danielopaleye01/SmartHomeSystem/Smart Home System PROTOtype.md

Smart Home System PROTOtype

HC-SR501 Motion SENSOR

-Multiple sensors across the home that detect for motion, (excluding pets)

DHT11 sensor

-After base temperatures set, If under, turns on, if over, turns off/down. Activates when you enter the home

FAN & DC motor

-Turns on, turns off, on command
