danielopaleye01/SmartHomeSystem/Block diagram.pdf

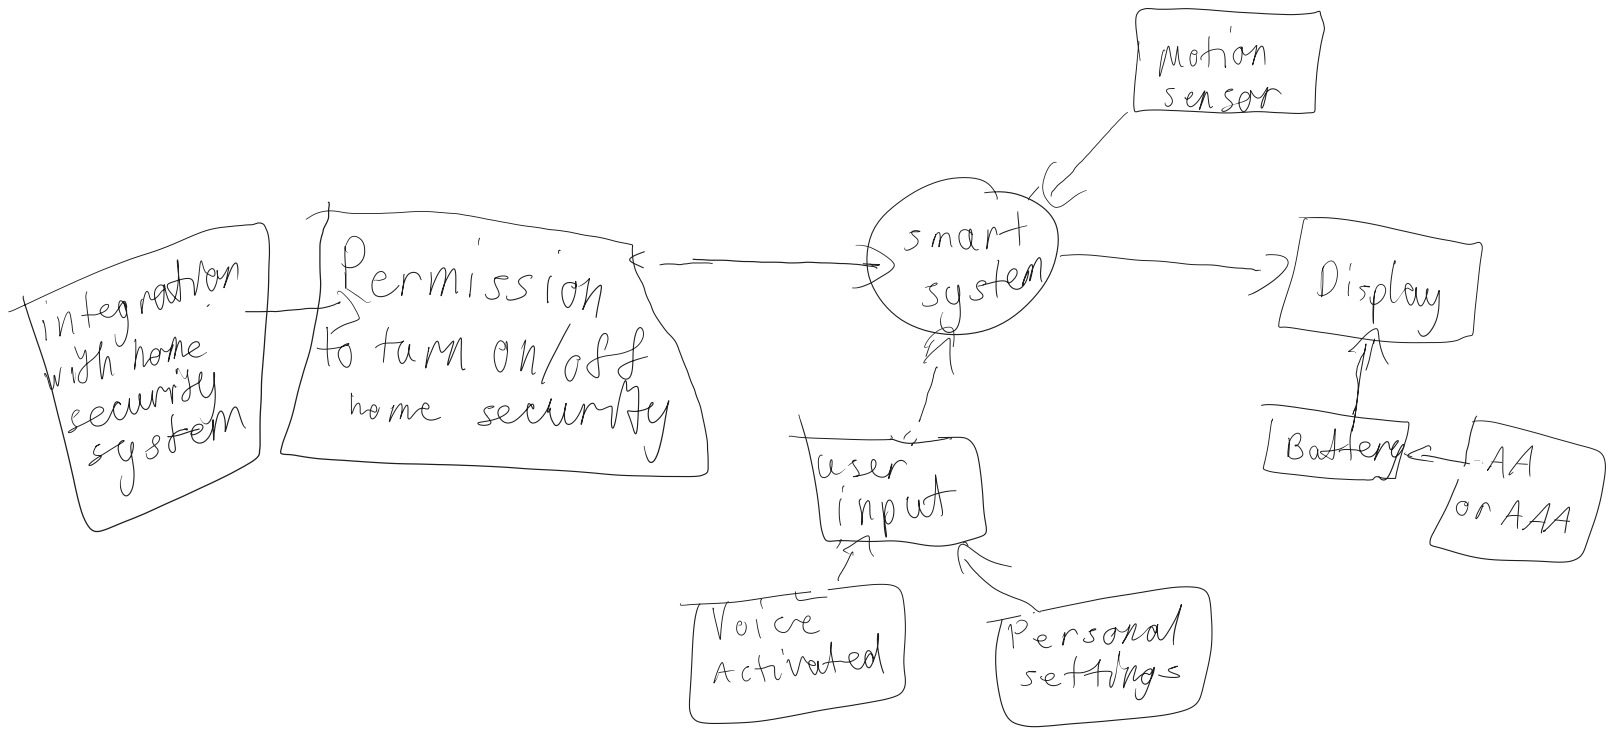
[picture p1: page 1]
