danielopaleye01/SmartHomeSystem/Final_Project430 2/Final_Project430 2/ProjectScematic_PCBv2.kicad_pcb

## KiCad design Final_Project430 2/Final_Project430 2/ProjectScematic_PCBv2.kicad_pcb (2025-05-15)

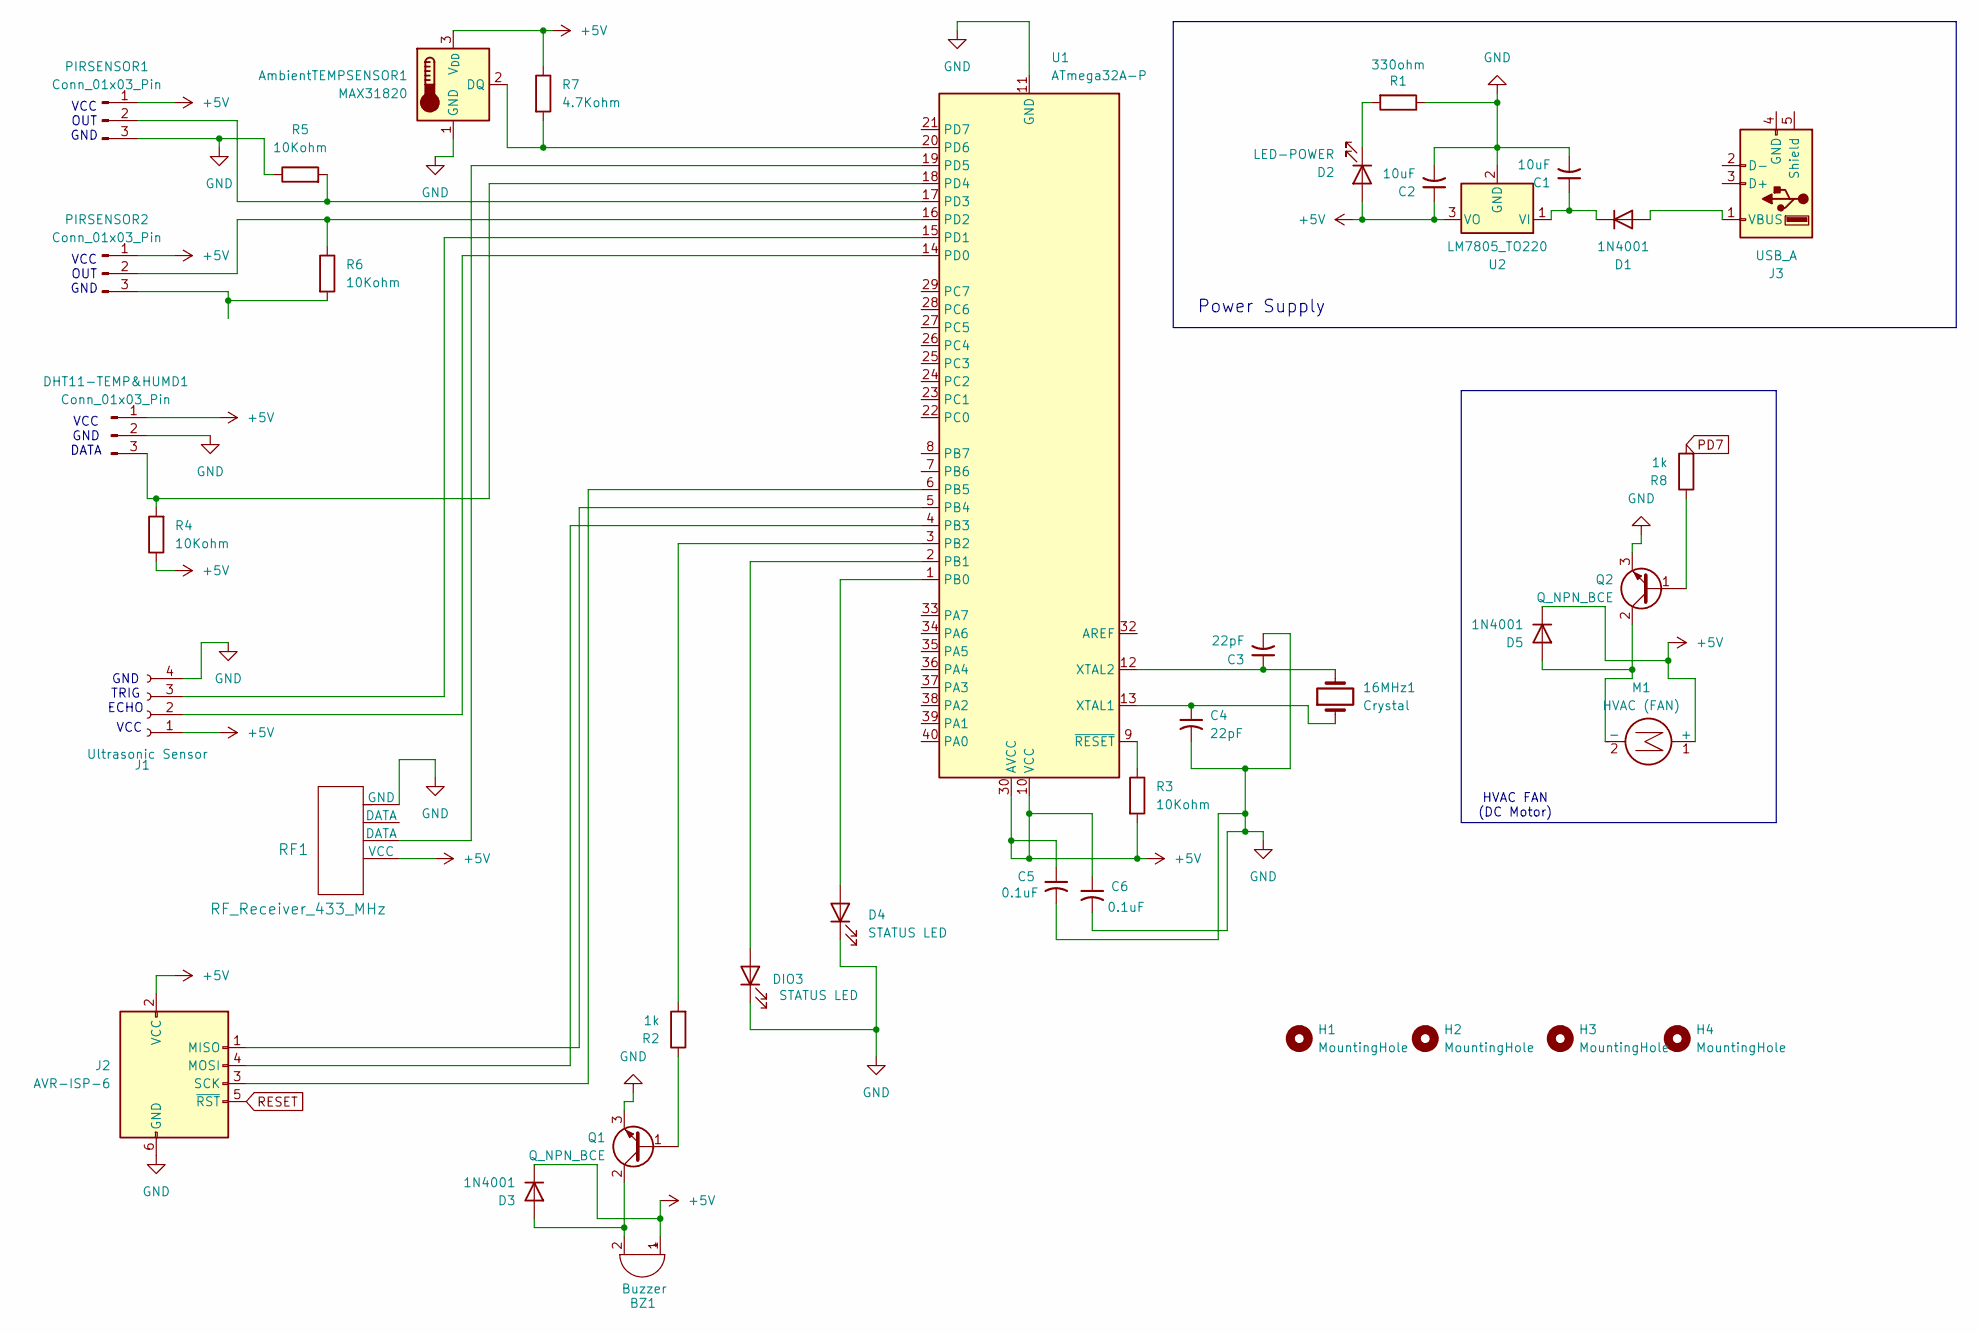
[picture p2: schematic ProjectScematic_PCBv2.kicad_sch, Final Project Schematic]

Parts:
16MHz1: Crystal; Crystal_HC49-U_Vertical
AmbientTEMPSENSOR1: MAX31820; TO-92_Inline
BZ1: Buzzer; Buzzer_12x9.5RM7.6
C1, C2: 10uF; C_Elec_5x5.4
C3, C4: 22pF; C_Elec_5x5.4
C5, C6: 0.1uF; C_Elec_5x5.4
D1, D3, D5: 1N4001; D_DO-41_SOD81_P10.16mm_Horizontal
D2: LED-POWER; LED_PLCC-2_3x2mm_AK
D4: STATUS LED; LED_1W_3W_R8
DHT11-TEMP&HUMD1: Conn_01x03_Pin; PinSocket_1x03_P2.54mm_Vertical
DIO3: STATUS LED; LED-L1T2_LUMILEDS
H1, H2, H3, H4: MountingHole; MountingHole_2.1mm
J1: Ultrasonic Sensor; AMS_OLGA12
J2: AVR-ISP-6; PinHeader_2x03_P2.54mm_Vertical
J3: USB_A; USB_A_CNCTech_1001-011-01101_Horizontal
M1: HVAC (FAN); FanPinHeader_1x03_P2.54mm_Vertical
PIRSENSOR1, PIRSENSOR2: Conn_01x03_Pin; FanPinHeader_1x03_P2.54mm_Vertical
Q1, Q2: Q_NPN_BCE; GaN_Systems_GaNPX-3_5x6.6mm_Drain2.93x0.6mm
R1: 330ohm; R_0201_0603Metric_Pad0.64x0.40mm_HandSolder
R2, R8: 1k; R_0201_0603Metric_Pad0.64x0.40mm_HandSolder
R3, R4, R5, R6: 10Kohm; R_0201_0603Metric_Pad0.64x0.40mm_HandSolder
R7: 4.7Kohm; R_0201_0603Metric_Pad0.64x0.40mm_HandSolder
RF1: RF_Receiver_433_MHz; Skyworks_SKY65404-31
U1: ATmega32A-P; DIP-40_W15.24mm
U2: LM7805_TO220; TO-220-3_Vertical

Connections:
+5V: AmbientTEMPSENSOR1.3 (V_{DD}), BZ1.1 (+), C2.1, C5.1, C6.1, D2.2 (A), D3.1 (K), D5.1 (K), DHT11-TEMP&HUMD1.1, J1.1, J2.2 (VCC), M1.1 (+), PIRSENSOR1.1, PIRSENSOR2.1, R3.2, R4.1, R7.1, RF1.1 (VCC), U1.10 (VCC), U1.30 (AVCC), U2.3 (VO)
GND: AmbientTEMPSENSOR1.1 (GND), C1.2, C2.2, C3.2, C4.2, C5.2, C6.2, D4.1 (K), DHT11-TEMP&HUMD1.2, DIO3.1 (K), J1.4, J2.6 (GND), PIRSENSOR1.3, Q1.3 (E), Q2.3 (E), R1.1, R5.1, RF1.4 (GND), U1.11 (GND), U1.31 (GND), U2.2 (GND)
unnamed: AmbientTEMPSENSOR1.2 (DQ), R7.2, U1.20 (PD6)
unnamed: BZ1.2 (-), D3.2 (A), Q1.2 (C)
unnamed: D1.2 (A), J3.1 (VBUS)
unnamed: C1.1, D1.1 (K), U2.1 (VI)
unnamed: D2.1 (K), R1.2
unnamed: D4.2 (A), U1.1 (PB0)
unnamed: D5.2 (A), M1.2 (-), Q2.2 (C)
unnamed: DHT11-TEMP&HUMD1.3, R4.2, U1.18 (PD4)
unnamed: DIO3.2 (A), U1.2 (PB1)
unnamed: J1.2, U1.14 (PD0)
unnamed: J1.3, U1.15 (PD1)
unnamed: J2.1 (MISO), U1.5 (PB4)
unnamed: J2.4 (MOSI), U1.4 (PB3)
unnamed: J2.3 (SCK), U1.6 (PB5)
unnamed: PIRSENSOR1.2, R5.2, U1.17 (PD3)
unnamed: PIRSENSOR2.2, R6.1, U1.16 (PD2)
unnamed: PIRSENSOR2.3, R6.2
unnamed: Q1.1 (B), R2.1
unnamed: Q2.1 (B), R8.1
unnamed: R2.2, U1.3 (PB2)
unnamed: RF1.2 (DATA), U1.19 (PD5)
unnamed: 16MHz1.1, C4.1, U1.13 (XTAL1)
unnamed: 16MHz1.2, C3.1, U1.12 (XTAL2)
unnamed: R3.1, U1.9 (~RESET)
PD7: R8.2
RESET: J2.5 (~RST)

Notes on the sheet:
VCC GND DATA
VCC
VCC OUT GND
HVAC FAN (DC Motor)
Power Supply
GND TRIG ECHO

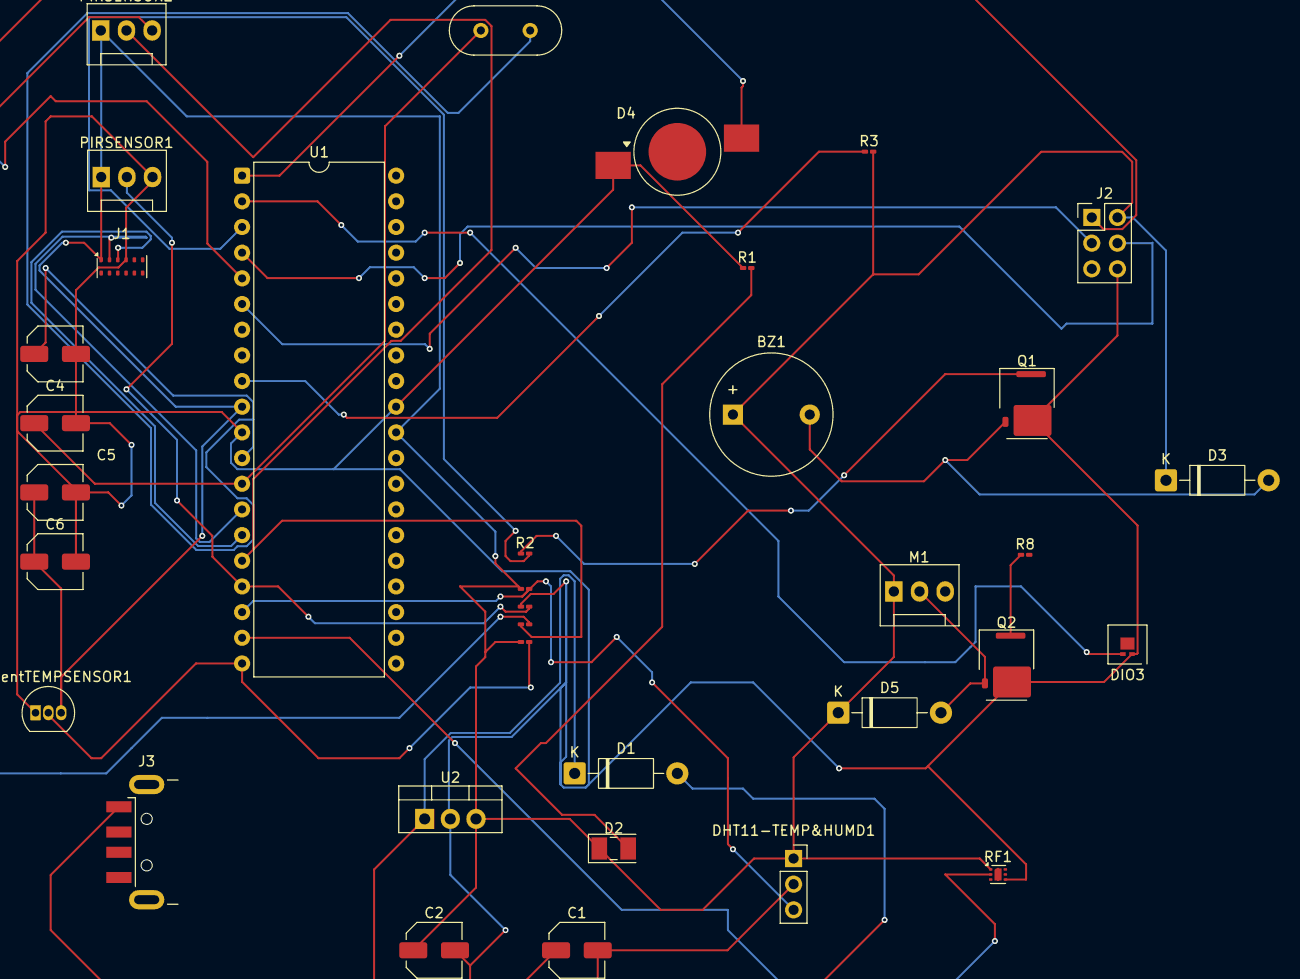
[picture p3: board ProjectScematic_PCBv2.kicad_pcb from above]

Board: 2 copper layers, 39 parts (0 on the bottom side), 26 nets.
