danielopaleye01/SmartHomeSystem/(commit log)

2025-02-04 Add files via upload
    3 Prototype types
2025-02-04 Update and rename Smart Home System PROTOtype.txt to Smart Home System PROTOtype.md
2025-05-15 KiCad Zip Folder
2025-05-15 Gerber Files Zip Folder
2025-05-15 Drill File
    [pcb layout-job.gbrjob]
2025-05-15 Gerber and Drill Files
    Compressed folder containing the Gerber and Drill files
2025-05-15 Delete pcb layout-job.gbrjob
    Reuploaded Gerber file folder with Drill files (including this one). Deleting this one here to avoid redundancy.
    [pcb layout-job.gbrjob]
2025-05-15 Delete Gerber_and_Drill_Files.zip
    These were outdated.
